korneliuszo/nhci/(list of files, drawings)

Other design files:
sch/prog.dsn
