korneliuszo/nhci/sch/nhci.kicad_pcb

## KiCad design sch/nhci.kicad_pcb (2021-09-21)

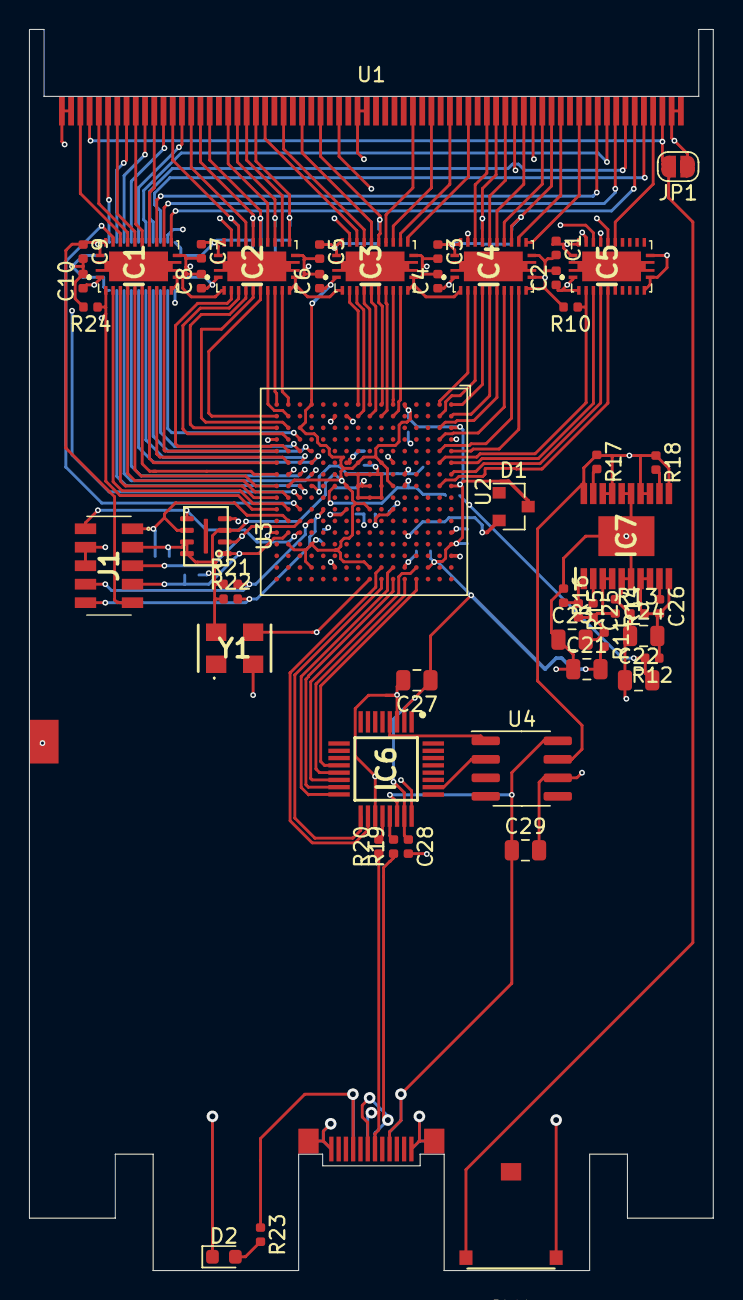
[picture p1: board nhci.kicad_pcb from above]

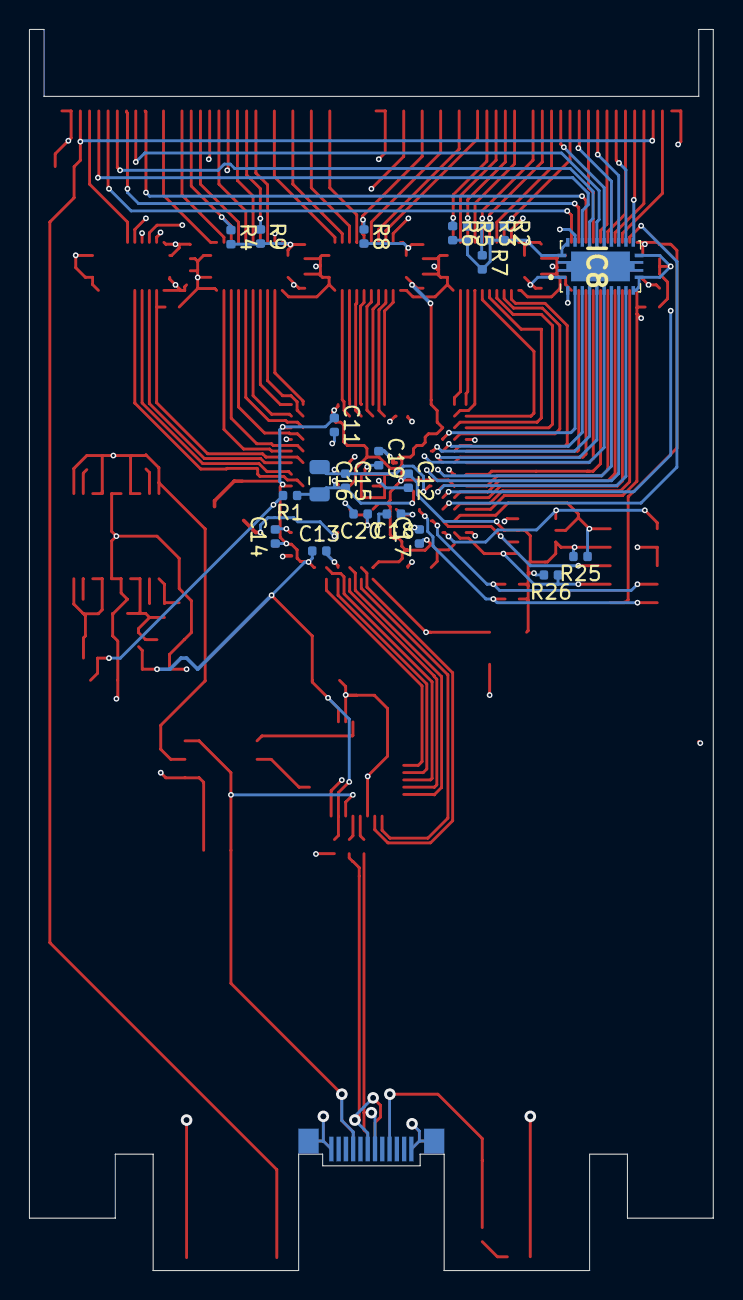
[picture p2: board nhci.kicad_pcb from below]

Board: 4 copper layers, 47.0 x 85.3 mm, 73 parts (22 on the bottom side), 128 nets.

Parts:
C1, C2, C3, C4, C5, C6, C7, C8, C9, C10, C11, C12, C13, C14, C15, C17, C28: 100nF; C_0402_1005Metric
C16, C21, C22, C23: 10uF; C_0805_2012Metric
C18, C19, C20, C25, C26: 10nF; C_0402_1005Metric
C24, C29: 4.7uF; C_0805_2012Metric
C27: 1uF; C_0805_2012Metric
D1: BAT54S; SOT-23
D2: LED; LED_0603_1608Metric
IC1, IC2, IC3, IC4, IC5, IC8: 74LVC8T245RHLRG4
IC6: MAX3421EEHJ+; QFP50P700X700X120-32N
IC7: LT3030IFE#TRPBF; SOP65P640X120-21N
J1: CLP-105-02-F-D; CLP-105-02-XXX-D
JP1: SolderJumper_2_Bridged; SolderJumper-2_P1.3mm_Open_RoundedPad1.0x1.5mm
R1, R13, R14: 100; R_0402_1005Metric
R2, R3, R4, R5, R6, R7, R8, R10, R21, R22, R24, R25, R26: 10k; R_0402_1005Metric
R9: 100k; R_0402_1005Metric
R11, R12: 0.1; R_0402_1005Metric
R15: 357k; R_0402_1005Metric
R16: 210k; R_0402_1005Metric
R17, R18: 1M; R_0402_1005Metric
R19, R20: 33; R_0402_1005Metric
R23: 1k; R_0402_1005Metric
SW1: SW_Push_Open; KSM1131
U1: PCMCIA_BOARD; PCMCIA_CARD
U2: iCE40-HX8K-CT256; BGA-256_14.0x14.0mm_Layout16x16_P0.8mm_Ball0.45mm_Pad0.32mm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
U3: N25Q032A13EF440F
U4: LM3526M-H; SOIC-8_3.9x4.9mm_P1.27mm
Y1: ECS-5032MV-120-BM-TR; ECS5032MV120BMTR

Connections:
12MHz: IC6.24, U2.H16, Y1.3
+1V2: C18.1, C19.1, C20.1, C22.2, R1.2, R12.2, U2.A14, U2.F6, U2.F10, U2.K6, U2.K10, U2.L2
+3V3: C2.1, C4.1, C6.1, C8.1, C10.1, C11.1, C12.1, C13.1, C14.1, C17.1, C21.2, C27.1, C28.1, D1.3, IC1.1, IC2.1, IC3.1, IC4.1, IC5.1, IC5.2, IC6.2, IC6.23, IC8.1, J1.3, R11.2, R21.1, R22.1, R25.2, R26.2, U2.A3, U2.A8, U2.A13, U2.C15, U2.E1, U2.F8, U2.G6, U2.H10, U2.H15, U2.J6, U2.K8, U2.N1, U2.N13, U2.N15, U2.P3, U2.R8, U2.R13, U3.3, U3.7, U3.8, Y1.4
+5V: C1.1, C3.1, C5.1, C7.1, C9.1, IC1.23, IC1.24, IC2.23, IC2.24, IC3.23, IC3.24, IC4.23, IC4.24, IC5.23, IC5.24, IC7.11, IC7.13, IC7.14, IC7.17, IC7.18, IC7.20, IC8.23, IC8.24, J1.9, R2.2, R3.2, R4.2, R5.2, R6.2, R7.2, R8.2, R9.2, R17.1, R18.1, U1.17, U1.51, U4.7
/P_A0: IC4.14, U1.29
/P_A1: IC4.15, U1.28
/P_A2: IC4.17, U1.27
/P_A3: IC4.18, U1.26
/P_A4: IC4.19, U1.25
/P_A5: IC4.21, U1.24
/P_A6: IC3.14, U1.23
/P_A7: IC3.15, U1.22
/P_A8: IC3.21, U1.12
/P_A9: IC2.15, U1.11
/P_A10: IC2.20, U1.8
/P_A11: IC2.17, U1.10
/P_A12: IC3.16, U1.21
/P_A13: IC3.20, U1.13
/P_A14: IC3.19, U1.14
/P_A15: IC3.17, U1.20
/P_CE1: IC2.21, R2.1, U1.7
/P_CE2: IC2.19, R3.1, U1.42
/P_D0: IC1.16, U1.30
/P_D1: IC1.15, U1.31
/P_D2: IC1.14, U1.32
/P_D3: IC1.21, U1.2
/P_D4: IC1.20, U1.3
/P_D5: IC1.19, U1.4
/P_D6: IC1.18, U1.5
/P_D7: IC1.17, U1.6
/P_D8: IC8.19, U1.64
/P_D9: IC8.20, U1.65
/P_D10: IC8.21, U1.66
/P_D11: IC8.14, U1.37
/P_D12: IC8.15, U1.38
/P_D13: IC8.16, U1.39
/P_D14: IC8.17, U1.40
/P_D15: IC8.18, U1.41
/P_INPACK: IC5.19, U1.60
/P_IORD: IC2.16, R5.1, U1.44
/P_IOWR: IC2.14, R6.1, U1.45
/P_OE: IC2.18, R7.1, U1.9
/P_READY: IC5.21, U1.16
/P_REG: IC4.16, R4.1, U1.61
/P_RESET: IC4.20, R9.1, U1.58
/P_WAIT: IC5.20, U1.59
/P_WE: IC3.18, R8.1, U1.15
/P_WP: IC5.18, U1.33
CDONE: J1.10, R22.2, U2.M10
CRESET: J1.8, R21.2, U2.N11
F_A0: IC4.10, U2.A5
F_A1: IC4.9, U2.B5
F_A2: IC4.7, U2.B3
F_A3: IC4.6, U2.A2
F_A4: IC4.5, U2.A1
F_A5: IC4.3, U2.B1
F_A6: IC3.10, U2.F2
F_A7: IC3.9, U2.F1
F_A8: IC3.3, U2.J1
F_A9: IC2.9, U2.T1
F_A10: IC2.4, U2.R4
F_A11: IC2.7, U2.T2
F_A12: IC3.8, U2.G2
F_A13: IC3.4, U2.J2
F_A14: IC3.5, U2.H1
F_A15: IC3.7, U2.G1
F_CE1: IC2.3, U2.R5
F_CE1O: IC1.22, U2.P10
F_CE2: IC2.5, U2.T3
F_CE2O: IC8.22, U2.P9
F_D0: IC1.8, U2.T6
F_D1: IC1.9, U2.R6
F_D2: IC1.10, U2.T5
F_D3: IC1.3, U2.R10
F_D4: IC1.4, U2.T9
F_D5: IC1.5, U2.R9
F_D6: IC1.6, U2.T8
F_D7: IC1.7, U2.T7
F_D8: IC8.5, U2.N5
F_D9: IC8.4, U2.P5
F_D10: IC8.3, U2.P4
F_D11: IC8.10, U2.P8
F_D12: IC8.9, U2.N7
F_D13: IC8.8, U2.P7
F_D14: IC8.7, U2.N6
F_D15: IC8.6, U2.P6
F_DDIR: IC1.2, IC8.2, R24.1, U2.T10
F_INPACK: IC5.5, U2.A7
F_IORD: IC2.8, U2.R2
F_IOWR: IC2.10, U2.R1
F_OE: IC2.6, U2.R3
F_READY: IC5.3, R10.1, U2.B6
F_REG: IC4.8, U2.B4
F_RESET: IC4.4, U2.B2
F_WAIT: IC5.4, U2.A6
F_WE: IC3.6, U2.H2
F_WP: IC5.6, U2.B8
GND: C1.2, C2.2, C3.2, C4.2, C5.2, C6.2, C7.2, C8.2, C9.2, C10.2, C11.2, C12.2, C13.2, C14.2, C17.2, C18.2, C19.2, C20.2, C21.1, C22.1, C23.1, C24.1, C27.2, C28.2, C29.2, D2.1, IC1.11, IC1.12, IC1.13, IC2.2, IC2.11, IC2.12, IC2.13, IC2.22, IC3.2, IC3.11, IC3.12, IC3.13, IC3.22, IC4.2, IC4.11, IC4.12, IC4.13, IC4.22, IC5.11, IC5.12, IC5.13, IC5.22, IC6.3, IC6.19, IC7.5, IC7.6, IC7.15, IC7.16, IC7.21, IC8.11, IC8.12, IC8.13, J1.4, J1.6, JP1.1, R10.2, R13.1, R14.1, R16.1, R24.2, SW1.1, U1.1, U1.34, U1.35, U1.68, U1.A1, U1.A12, U1.B1, U1.B12, U1.GCLIP, U1.SH, U1.SH2, U1.SH3, U1.SH4, U2.A4, U2.A12, U2.E15, U2.G7, U2.G8, U2.G9, U2.H7, U2.H8, U2.H9, U2.J7, U2.J8, U2.J9, U2.K2, U2.K7, U2.L15, U2.R7, U2.T4, U2.T12, U3.4, U4.6, Y1.2
unnamed: C15.1, C16.1, U2.E7, U2.N8
unnamed: C15.2, C16.2, R1.1, U2.E8, U2.L8
unnamed: C23.2, C25.2, IC7.3, IC7.4, R11.1, R14.2, R15.2
unnamed: C24.2, C26.2, IC7.7, IC7.8, IC7.10, R12.1, R13.2
unnamed: C25.1, IC7.2
unnamed: C26.1, IC7.9
unnamed: C29.1, IC6.22, R23.1, U1.A4, U1.A9, U1.B4, U1.B9, U4.8
unnamed: D1.2, U2.E12
unnamed: D2.2, R23.2
unnamed: IC6.4, U4.1
unnamed: IC6.20, R20.2
unnamed: IC6.21, R19.2
unnamed: IC6.26, U4.2
unnamed: IC7.1, R15.1, R16.2
unnamed: IC7.12, R18.2
unnamed: IC7.19, R17.2
unnamed: J1.1, R25.1, U2.R11, U3.6
unnamed: J1.2, U2.P12, U3.5
unnamed: J1.5, U2.P11, U3.2
unnamed: J1.7, R26.1, U2.R12, U3.1
unnamed: JP1.2, SW1.2, U1.36, U1.67
unnamed: R19.1, U1.A6, U1.B6
unnamed: R20.1, U1.A7, U1.B7
U_GPX: IC6.17, U2.G16
U_INT: IC6.18, U2.G15
U_MISO: IC6.15, U2.F16
U_MOSI: IC6.16, U2.F15
U_RES: IC6.12, U2.D16
U_SCLK: IC6.13, U2.E16
U_SS: IC6.14, U2.D15
