korneliuszo/nhci/sch/prog.kicad_pcb

## KiCad design sch/prog.kicad_pcb (2021-04-23)

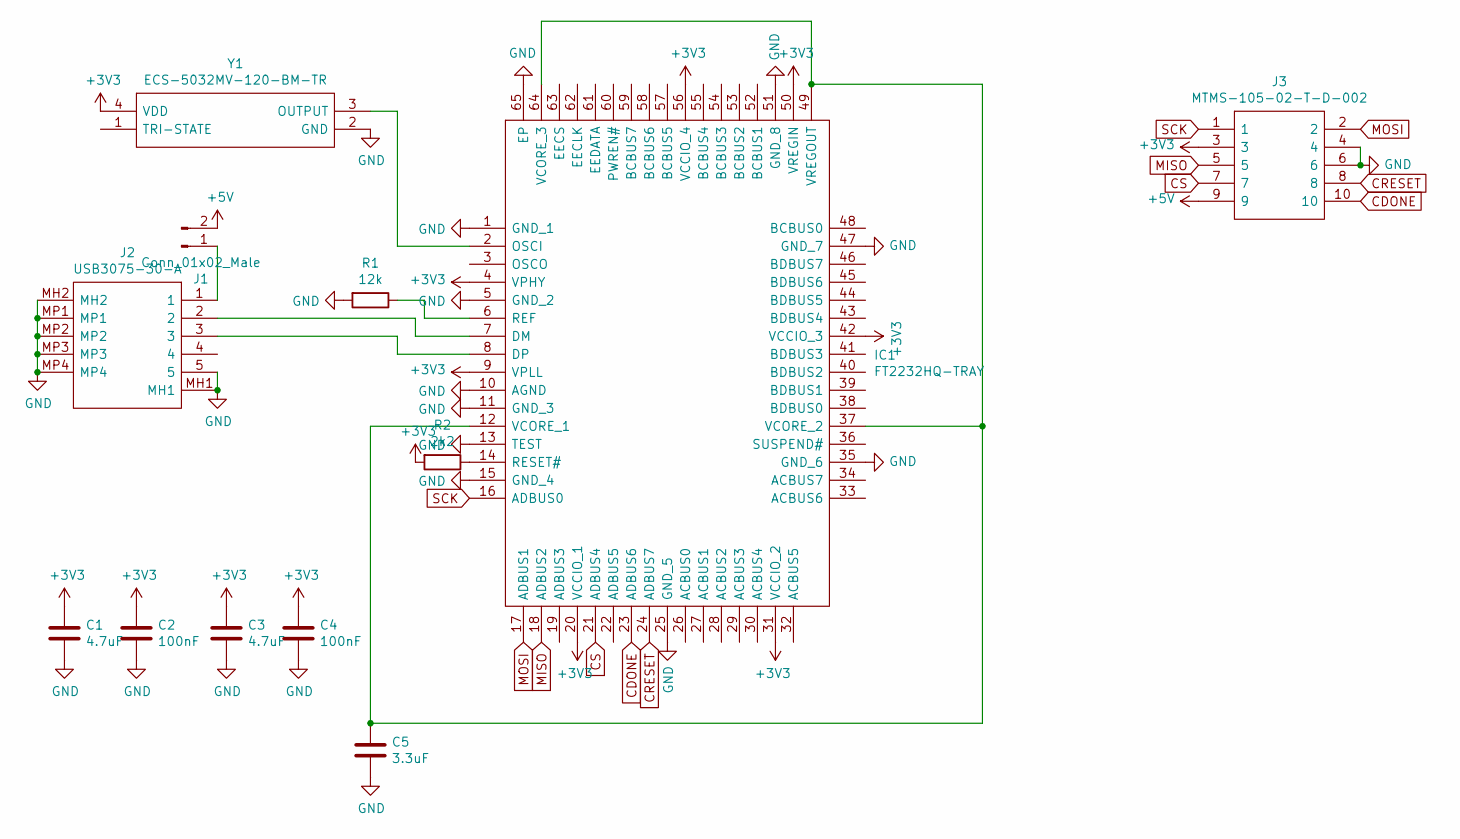
[picture p3: schematic prog.sch]

Parts:
C1, C3: 4.7uF; C_0805_2012Metric
C2, C4: 100nF; C_0805_2012Metric
C5: 3.3uF; C_0805_2012Metric
IC1: FT2232HQ-TRAY; QFN50P900X900X90-65N-D; Manufacturer_Part_Number FT2232HQ-TRAY; Mouser Part Number 895-FT2232HQ-TRAY
J1: Conn_01x02_Male; PinHeader_1x02_P2.54mm_Horizontal
J2: USB3075-30-A; USB307530A; Manufacturer_Part_Number USB3075-30-A
J3: MTMS-105-02-T-D-002; MTMS10502TD002; Manufacturer_Part_Number MTMS-105-02-T-D-002; Mouser Part Number 200-MTMS10502TD002
R1: 12k; R_0805_2012Metric
R2: 2k2; R_0805_2012Metric
Y1: ECS-5032MV-120-BM-TR; ECS5032MV120BMTR; Manufacturer_Part_Number ECS-5032MV-120-BM-TR; Mouser Part Number 520-5032MV-120-BMT

Connections:
+3V3: C1.1, C2.1, C3.1, C4.1, IC1.4 (VPHY), IC1.9 (VPLL), IC1.20 (VCCIO_1), IC1.31 (VCCIO_2), IC1.42 (VCCIO_3), IC1.50 (VREGIN), IC1.56 (VCCIO_4), J3.3, R2.2, Y1.4 (VDD)
+5V: J1.2, J3.9
CDONE: IC1.23 (ADBUS6), J3.10
CRESET: IC1.24 (ADBUS7), J3.8
CS: IC1.21 (ADBUS4), J3.7
GND: C1.2, C2.2, C3.2, C4.2, C5.2, IC1.1 (GND_1), IC1.5 (GND_2), IC1.10 (AGND), IC1.11 (GND_3), IC1.13 (TEST), IC1.15 (GND_4), IC1.25 (GND_5), IC1.35 (GND_6), IC1.47 (GND_7), IC1.51 (GND_8), IC1.65 (EP), J2.5, J2.MH1, J2.MH2, J2.MP1, J2.MP2, J2.MP3, J2.MP4, J3.4, J3.6, R1.2, Y1.2 (GND)
MISO: IC1.18 (ADBUS2), J3.5
MOSI: IC1.17 (ADBUS1), J3.2
unnamed: C5.1, IC1.12 (VCORE_1), IC1.37 (VCORE_2), IC1.49 (VREGOUT), IC1.64 (VCORE_3)
unnamed: IC1.2 (OSCI), Y1.3 (OUTPUT)
unnamed: IC1.6 (REF), R1.1
unnamed: IC1.7 (DM), J2.2
unnamed: IC1.8 (DP), J2.3
unnamed: IC1.14 (RESET#), R2.1
unnamed: J1.1, J2.1
SCK: IC1.16 (ADBUS0), J3.1

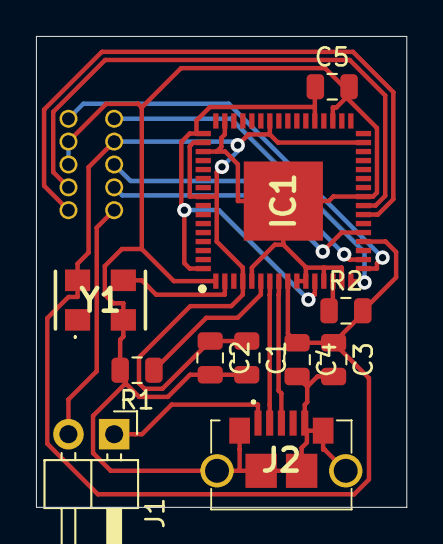
[picture p4: board prog.kicad_pcb from above]

Board: 2 copper layers, 20.6 x 26.2 mm, 12 parts (1 on the bottom side), 16 nets.
