korneliuszo/nhci/fw/ic.v

`include "top.v"

module ic(
	input wire CLK,
	inout wire [7:0] D,
	input wire [15:0] A,
	output wire DDIR,
	input wire RESET,
	input wire WE,
	input wire OE,
	input wire IOWR,
	input wire IORD,
	input wire CE1,
	input wire CE2,
	input wire REG,
	output wire WAIT,
	output wire INPACK,
	output wire READY,
	output wire WP,
	output wire SS,
	output wire SCLK,
	output wire MOSI,
	input wire MISO,
	output wire U_RES,
	input wire INT
	);

	wire clk_52;
	SB_PLL40_CORE #(
`include "pll.v"
	)  SB_PLL40_CORE_inst (
		.RESETB(1'b1),
		.BYPASS(1'b0),
		.PLLOUTGLOBAL(clk_52),
		.REFERENCECLK(CLK)
	);

	wire INT_int;
	SB_IO #(
			.PIN_TYPE(6'b 0000_01),
			.PULLUP(1'b 1)
		) button_input(
			.PACKAGE_PIN(INT),
			.D_IN_0(INT_int)
		);

	wire [7:0] D_in;
	wire [7:0] D_out;
	assign D = DDIR ? D_out : 8'bZ;
	assign D_in = D;

	top top(
		clk_52,
		D_in,
		D_out,
		A,
		DDIR,
		RESET,
		WE,
		OE,
		IOWR,
		IORD,
		CE1,
		CE2,
		REG,
		WAIT,
		INPACK,
		READY,
		WP,
		SS,
		SCLK,
		MOSI,
		MISO,
		U_RES,
		INT_int
	 	);

endmodule
