korneliuszo/nhci/fw/rom.v

module rom(
	output wire [7:0] D,
	input wire [15:0] A,
	output wire DDIR,
	input wire REGSELB,
	input wire OE,
	);
	
	reg [7:0] mem [0:255];
	
	assign DDIR = !(REGSELB | OE) & !(A[9]);
	assign D = mem[A[8:1]];
	
initial begin
	$readmemh("attr.list", mem);
end

endmodule
