korneliuszo/nhci/(commit log)

2021-04-19 Stub windows driver
2021-04-20 Add switch
2021-04-21 Add PCMCIA footprint (TODO: USB connector)
2021-04-22 Add nonfinished schematic
    [FPGA.sch, nhci.kicad_pcb, nhci.sch, pwr.sch, usbh.sch]
2021-04-22 Add pullup resistors
    [nhci.kicad_pcb, nhci.sch]
2021-04-22 Add voltage regulator
    [FPGA.sch, nhci.kicad_pcb, pwr.sch, usbh.sch]
2021-04-22 Add usb controller
    [FPGA.sch, nhci.kicad_pcb, usbh.sch]
2021-04-22 Add solder jumper for non development board
    [nhci.kicad_pcb, nhci.sch]
2021-04-22 Route forgotten
    [nhci.kicad_pcb]
2021-04-22 Add programming connector
    [FPGA.sch, nhci.kicad_pcb]
2021-04-22 Add missing route
    [nhci.kicad_pcb]
2021-04-22 Add start programmer
    [prog.kicad_pcb, prog.sch]
2021-04-22 Add proper value of resistors
    [FPGA.sch, nhci.kicad_pcb]
2021-04-22 Add power led
    [nhci.kicad_pcb, usbh.sch]
2021-04-22 Add pulldown resistor so when FPGA boots no load on data bus
    [nhci.kicad_pcb, usbh.sch]
2021-04-23 Add Connector
    [nhci.kicad_pcb, usbh.sch]
2021-04-23 Add eaten resistor (move between machines)
    [nhci.kicad_pcb]
2021-04-23 Replace diode
    [FPGA.sch, nhci.kicad_pcb]
2021-04-23 VCC is 1V2 not 3V3
    [FPGA.sch, nhci.kicad_pcb]
2021-04-23 Add recommended SPI pullups
    [FPGA.sch, nhci.kicad_pcb]
2021-04-23 Add edge cuts
    [nhci.kicad_pcb]
2021-04-23 Add gerbers (commit to manufacture?)
    [nhci-B_Cu.gbr, nhci-B_Mask.gbr, nhci-B_Paste.gbr, nhci-B_SilkS.gbr, nhci-Edge_Cuts.gbr, nhci-F_Cu.gbr, nhci-F_Mask.gbr, nhci-F_Paste.gbr]
2021-05-04 Spi slave simulator
2021-05-05 Add spi module
2021-05-06 Proper silkscreen and distances from pads
    [nhci.kicad_pcb]
2021-05-06 PCB V1.1
    [nhci-B_Cu.gbr, nhci-B_Mask.gbr, nhci-B_Paste.gbr, nhci-B_SilkS.gbr, nhci-Edge_Cuts.gbr, nhci-F_Cu.gbr, nhci-F_Mask.gbr, nhci-F_Paste.gbr]
2021-05-24 Fix spi
2021-05-24 Add test.py for switching on power to usb
2021-09-21 V2.0 board
    [FPGA.sch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]
